hugelton/SumaShield/LICENSES/README.md

# License Notes

This repository contains materials under more than one license:

- Firmware sketches and software documentation are licensed under the MIT License. See `../LICENSE`.
- Hardware design files, manufacturing outputs under `../hardware/`, and hardware-specific documentation are licensed under Creative Commons Attribution-ShareAlike 4.0 International. See `CC-BY-SA-4.0.txt`.
- Third-party Arduino libraries and board support packages are not vendored here. They remain under their upstream licenses.
- Suma Core is referenced as a related project under LGPL-2.1. Its license text is included as `LGPL-2.1.txt` for reference.

Known external build dependencies:

- Raspberry Pi Pico Arduino core / I2S support: upstream Arduino-Pico / bundled dependencies
- U8g2: new BSD / two-clause BSD for U8g2lib code, with separate font license notes upstream
- Adafruit TinyUSB Library: MIT
- MIDI Library by Forty Seven Effects: MIT
