hugelton/SumaShield/hardware/SumaShield.kicad_sch

## KiCad design hardware/SumaShield.kicad_sch (2026-05-06)

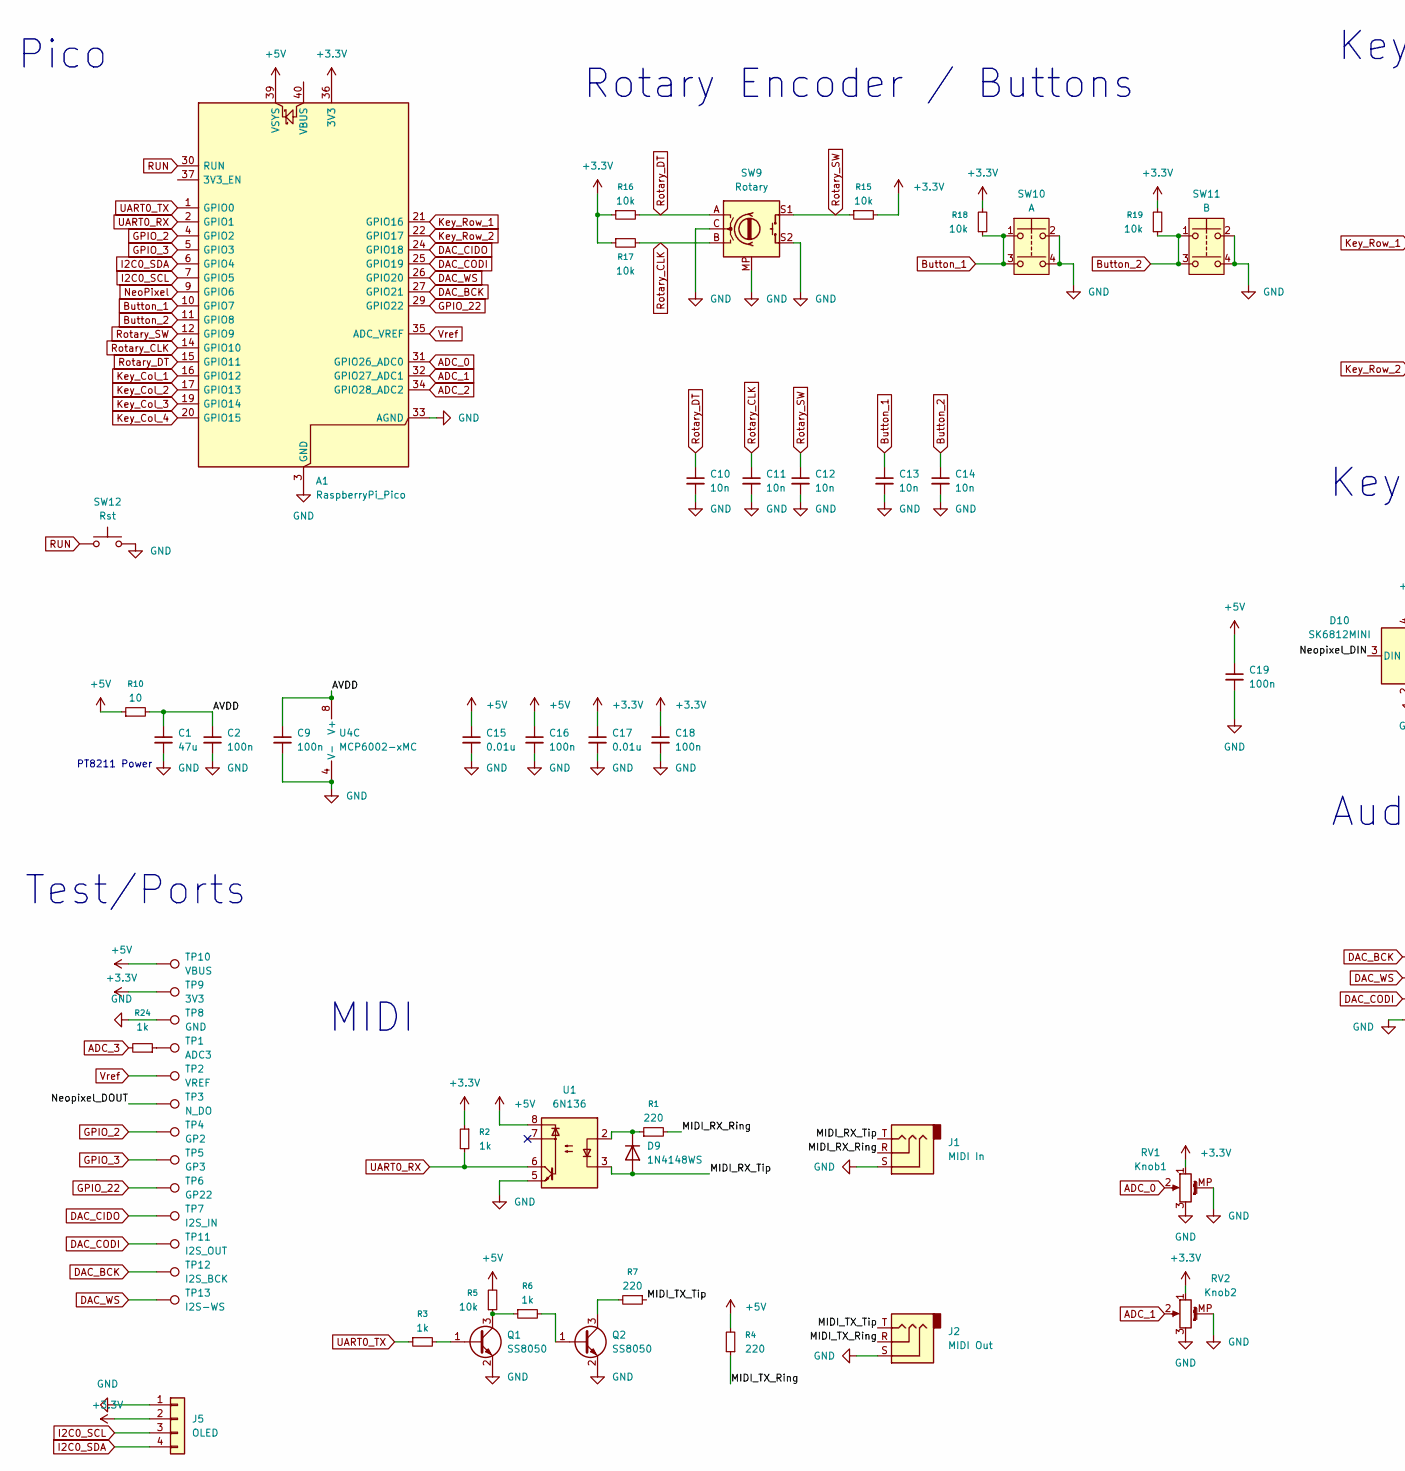
[picture p1: schematic SumaShield.kicad_sch, part in row 1, column 1]

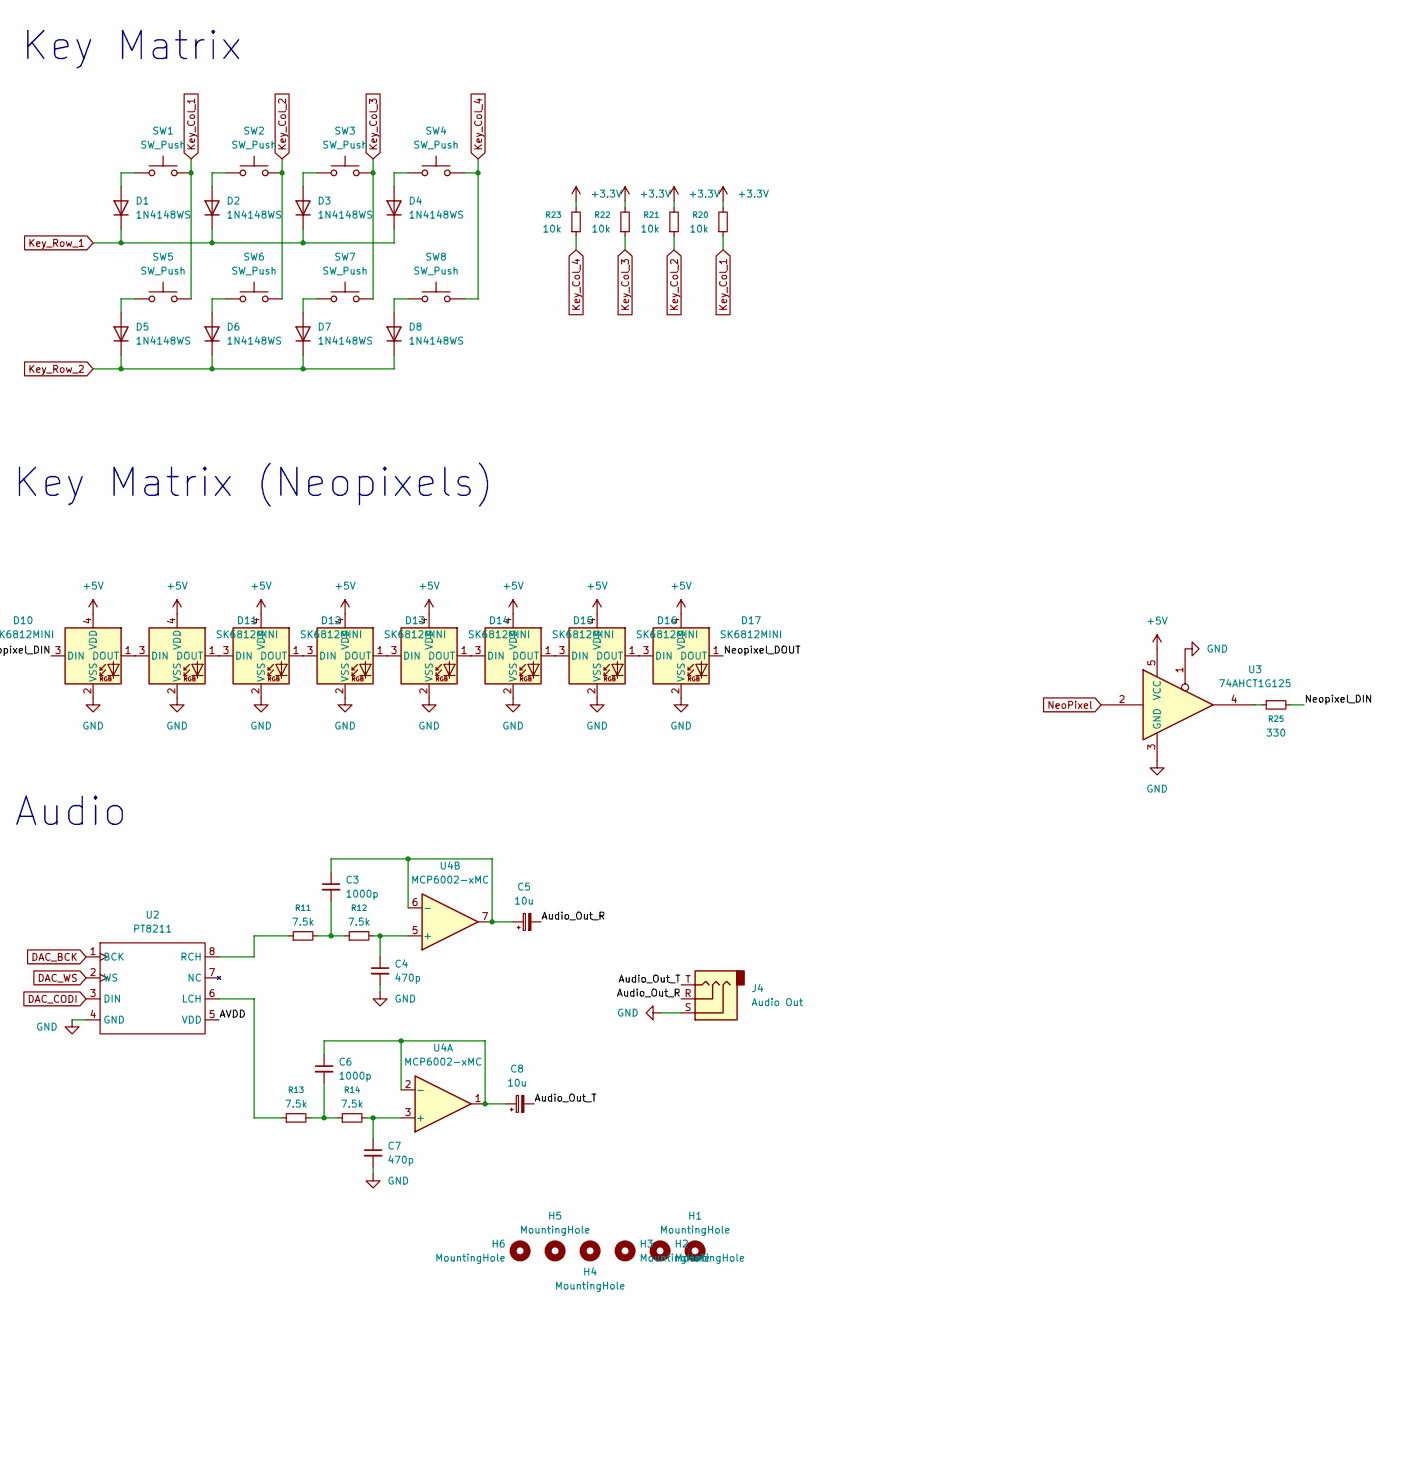
[picture p2: schematic SumaShield.kicad_sch, part in row 1, column 2]

Parts:
A1: RaspberryPi_Pico; RaspberryPi_Pico_Common_THT
C1: 47u; C_0603_1608Metric
C2, C9, C16, C18, C19: 100n; C_0603_1608Metric
C3, C6: 1000p; C_0603_1608Metric
C4, C7: 470p; C_0603_1608Metric
C5, C8: 10u; CP_Elec_6.3x5.4_Nichicon
C10, C11, C12, C13, C14: 10n; C_0603_1608Metric
C15, C17: 0.01u; C_0603_1608Metric
D1, D2, D3, D4, D5, D6, D7, D8, D9: 1N4148WS; D_SOD-323
D10, D11, D12, D13, D14, D15, D16, D17: SK6812MINI; LED_SK6812MINI_Through
H1, H2, H3, H4, H5, H6: MountingHole; MountingHole_3.2mm_M3
J1: MIDI In; Jack_3.5mm_Switronic_ST-005-G_horizontal
J2: MIDI Out; Jack_3.5mm_Switronic_ST-005-G_horizontal
J4: Audio Out; Jack_3.5mm_Switronic_ST-005-G_horizontal
J5: OLED; PinHeader_1x04_P2.54mm_Vertical; Part Number 1-0401FBV0T
Q1, Q2: SS8050; SOT-23
R1, R4, R7: 220; R_0603_1608Metric
R2, R3, R6, R24: 1k; R_0603_1608Metric
R5, R15, R16, R17, R18, R19, R20, R21, R22, R23: 10k; R_0603_1608Metric
R10: 10; R_0603_1608Metric
R11, R12, R13, R14: 7.5k; R_0603_1608Metric
R25: 330; R_0603_1608Metric
RV1: Knob1; ALPS_RK09L_Single_Vertical_15mm
RV2: Knob2; ALPS_RK09L_Single_Vertical_15mm
SW1, SW2, SW3, SW4, SW5, SW6, SW7, SW8: SW_Push; SW_Cherry_MX_1.00u_Plate
SW9: Rotary; RotaryEncoder_Alps_EC11E_Vertical_H20mm_CircularMountingHol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
SW10: A; SW_PUSH_6mm
SW11: B; SW_PUSH_6mm
SW12: Rst; SW_PUSH_1P1T_6x3.5mm_H5.0_APEM_MJTP1250
TP1: ADC3; TestPoint_Pad_D1.5mm
TP2: VREF; TestPoint_Pad_D1.5mm
TP3: N_DO; TestPoint_Pad_D1.5mm
TP4: GP2; TestPoint_Pad_D1.5mm
TP5: GP3; TestPoint_Pad_D1.5mm
TP6: GP22; TestPoint_Pad_D1.5mm
TP7: I2S_IN; TestPoint_Pad_D1.5mm
TP8: GND; TestPoint_Pad_D1.5mm
TP9: 3V3; TestPoint_Pad_D1.5mm
TP10: VBUS; TestPoint_Pad_D1.5mm
TP11: I2S_OUT; TestPoint_Pad_D1.5mm
TP12: I2S_BCK; TestPoint_Pad_D1.5mm
TP13: I2S-WS; TestPoint_Pad_D1.5mm
U1: 6N136; DIP-8_W7.62mm
U2: PT8211; SOP-8_3.76x4.96mm_P1.27mm
U3: 74AHCT1G125; SOT-23-5
U4: MCP6002-xMC; SOIC-8_3.9x4.9mm_P1.27mm

Connections:
+3.3V: A1.36 (3V3), C17.1, C18.1, J5.2, R2.1, R15.2, R16.1, R17.1, R18.2, R19.2, R20.2, R21.2, R22.2, R23.2, RV1.1, RV2.1, TP9.1
+5V: A1.39 (VSYS), C15.1, C16.1, C19.1, D10.4 (VDD), D11.4 (VDD), D12.4 (VDD), D13.4 (VDD), D14.4 (VDD), D15.4 (VDD), D16.4 (VDD), D17.4 (VDD), R4.2, R5.2, R10.1, TP10.1, U1.8, U3.5 (VCC)
ADC_0: A1.31 (GPIO26_ADC0), RV1.2
ADC_1: A1.32 (GPIO27_ADC1), RV2.2
ADC_2: A1.34 (GPIO28_ADC2)
ADC_3: R24.2
AVDD: C1.1, C2.1, C9.1, R10.2, U2.5 (VDD), U4.8 (V+)
Audio_Out_R: C5.2, J4.R
Audio_Out_T: C8.2, J4.T
Button_1: A1.10 (GPIO7), C13.1, R18.1, SW10.1, SW10.3
Button_2: A1.11 (GPIO8), C14.1, R19.1, SW11.1, SW11.3
DAC_BCK: A1.27 (GPIO21), TP12.1, U2.1 (BCK)
DAC_CIDO: A1.24 (GPIO18), TP7.1
DAC_CODI: A1.25 (GPIO19), TP11.1, U2.3 (DIN)
DAC_WS: A1.26 (GPIO20), TP13.1, U2.2 (WS)
GND: A1.3 (GND), A1.8 (GND), A1.13 (GND), A1.18 (GND), A1.23 (GND), A1.28 (GND), A1.33 (AGND), A1.38 (GND), C1.2, C2.2, C4.2, C7.2, C9.2, C10.2, C11.2, C12.2, C13.2, C14.2, C15.2, C16.2, C17.2, C18.2, C19.2, D10.2 (VSS), D11.2 (VSS), D12.2 (VSS), D13.2 (VSS), D14.2 (VSS), D15.2 (VSS), D16.2 (VSS), D17.2 (VSS), J1.S, J2.S, J4.S, J5.1, Q1.2 (E), Q2.2 (E), RV1.3, RV1.MP (MountPin), RV2.3, RV2.MP (MountPin), SW9.C, SW9.MP, SW9.S2, SW10.2, SW10.4, SW11.2, SW11.4, SW12.2, TP8.1, U1.5, U2.4 (GND), U3.1, U3.3 (GND), U4.4 (V-), U4.9 (V-)
GPIO_2: A1.4 (GPIO2), TP4.1
GPIO_3: A1.5 (GPIO3), TP5.1
GPIO_22: A1.29 (GPIO22), TP6.1
I2C0_SCL: A1.7 (GPIO5), J5.3
I2C0_SDA: A1.6 (GPIO4), J5.4
Key_Col_1: A1.16 (GPIO12), R20.1, SW1.2, SW5.2
Key_Col_2: A1.17 (GPIO13), R21.1, SW2.2, SW6.2
Key_Col_3: A1.19 (GPIO14), R22.1, SW3.2, SW7.2
Key_Col_4: A1.20 (GPIO15), R23.1, SW4.2, SW8.2
Key_Row_1: A1.21 (GPIO16), D1.1 (K), D2.1 (K), D3.1 (K), D4.1 (K)
Key_Row_2: A1.22 (GPIO17), D5.1 (K), D6.1 (K), D7.1 (K), D8.1 (K)
MIDI_RX_Ring: J1.R, R1.2
MIDI_RX_Tip: D9.2 (A), J1.T, U1.3
MIDI_TX_Ring: J2.R, R4.1
MIDI_TX_Tip: J2.T, R7.1
NeoPixel: A1.9 (GPIO6), U3.2
Neopixel_DIN: D10.3 (DIN), R25.2
Neopixel_DOUT: D17.1 (DOUT), TP3.1
unnamed: C3.1, C5.1, U4.6 (-), U4.7
unnamed: C3.2, R11.2, R12.1
unnamed: C4.1, R12.2, U4.5 (+)
unnamed: C6.1, C8.1, U4.1, U4.2 (-)
unnamed: C6.2, R13.2, R14.1
unnamed: C7.1, R14.2, U4.3 (+)
unnamed: D1.2 (A), SW1.1
unnamed: D2.2 (A), SW2.1
unnamed: D3.2 (A), SW3.1
unnamed: D4.2 (A), SW4.1
unnamed: D5.2 (A), SW5.1
unnamed: D6.2 (A), SW6.1
unnamed: D7.2 (A), SW7.1
unnamed: D8.2 (A), SW8.1
unnamed: D9.1 (K), R1.1, U1.2
unnamed: D10.1 (DOUT), D11.3 (DIN)
unnamed: D11.1 (DOUT), D12.3 (DIN)
unnamed: D12.1 (DOUT), D13.3 (DIN)
unnamed: D13.1 (DOUT), D14.3 (DIN)
unnamed: D14.1 (DOUT), D15.3 (DIN)
unnamed: D15.1 (DOUT), D16.3 (DIN)
unnamed: D16.1 (DOUT), D17.3 (DIN)
unnamed: Q1.1 (B), R3.2
unnamed: Q1.3 (C), R5.1, R6.1
unnamed: Q2.1 (B), R6.2
unnamed: Q2.3 (C), R7.2
unnamed: R11.1, U2.8 (RCH)
unnamed: R13.1, U2.6 (LCH)
unnamed: R24.1, TP1.1
unnamed: R25.1, U3.4
RUN: A1.30 (RUN), SW12.1
Rotary_CLK: A1.14 (GPIO10), C11.1, R17.2, SW9.B
Rotary_DT: A1.15 (GPIO11), C10.1, R16.2, SW9.A
Rotary_SW: A1.12 (GPIO9), C12.1, R15.1, SW9.S1
UART0_RX: A1.2 (GPIO1), R2.2, U1.6
UART0_TX: A1.1 (GPIO0), R3.1
Vref: A1.35 (ADC_VREF), TP2.1

Notes on the sheet:
Pico
Audio
MIDI
Test/Ports
Key Matrix (Neopixels)
Key Matrix
Rotary Encoder / Buttons
PT8211 Power
