hugelton/SumaShield/applications/SumaPiko/doth/filter.h

// Sample rate: 31000 Hz
#define LPF_MAX 45
int32_t x1_f, x2_f, y1_f, y2_f;
uint8_t filter_lpf(int32_t x, int32_t f_, uint8_t q) {
  int32_t y;
uint8_t f = f_;
if (f_<0) {
    f=0;
}

  if (f>LPF_MAX) f=LPF_MAX;
  if (f==0) {
      y = 4504 * x + 9007 * x1_f + 4504 * x2_f - -2002973 * y1_f - 972411 * y2_f; 
    }
  else if (f==1) {
      y = 5044 * x + 10087 * x1_f + 5044 * x2_f - -1996487 * y1_f - 968085 * y2_f; 
    }
  else if (f==2) {
      y = 5647 * x + 11294 * x1_f + 5647 * x2_f - -1989513 * y1_f - 963526 * y2_f; 
    }
  else if (f==3) {
      y = 6322 * x + 12644 * x1_f + 6322 * x2_f - -1982012 * y1_f - 958725 * y2_f; 
    }
  else if (f==4) {
      y = 7077 * x + 14153 * x1_f + 7077 * x2_f - -1973940 * y1_f - 953671 * y2_f; 
    }
  else if (f==5) {
      y = 7920 * x + 15840 * x1_f + 7920 * x2_f - -1965249 * y1_f - 948353 * y2_f; 
    }
  else if (f==6) {
      y = 8862 * x + 17724 * x1_f + 8862 * x2_f - -1955887 * y1_f - 942759 * y2_f; 
    }
  else if (f==7) {
      y = 9914 * x + 19829 * x1_f + 9914 * x2_f - -1945798 * y1_f - 936880 * y2_f; 
    }
  else if (f==8) {
      y = 11089 * x + 22179 * x1_f + 11089 * x2_f - -1934922 * y1_f - 930703 * y2_f; 
    }
  else if (f==9) {
      y = 12401 * x + 24802 * x1_f + 12401 * x2_f - -1923190 * y1_f - 924218 * y2_f; 
    }
  else if (f==10) {
      y = 13864 * x + 27729 * x1_f + 13864 * x2_f - -1910532 * y1_f - 917413 * y2_f; 
    }
  else if (f==11) {
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
    }
  else if (f==46) {
      y = 93228 * x + -186455 * xh1_f + 93228 * xh2_f - 1046160 * yh1_f - 370495 * yh2_f; 
    }
  else if (f==47) {
      y = 65288 * x + -130575 * xh1_f + 65288 * xh2_f - 1238065 * yh1_f - 450639 * yh2_f; 
    }
  else if (f==48) {
      y = 39603 * x + -79207 * xh1_f + 39603 * xh2_f - 1446967 * yh1_f - 556804 * yh2_f; 
    }
  else {
      y = 17960 * x + -35920 * xh1_f + 17960 * xh2_f - 1674703 * yh1_f - 697966 * yh2_f; 
    }
 y=y>>20;

  xh2_f = xh1_f;
  xh1_f = x;
  yh2_f = yh1_f;
  yh1_f = y;
  return (uint8_t)(y);

}
