hugelton/SumaShield/(commit log)

2026-05-06 Initial commit: SumaShield - RP2040 Music Applications
    - SumaDrums: 8-track drum sequencer with USB/DIN MIDI
    - SumaFormants: Monophonic formant vocoder synth
    - MIDITester: MIDI diagnostic tool
    - Dual-core architecture (UI + DSP)
    - OLED auto-sleep, real-time parameter control
    License: MIT (Software), CC BY-SA 4.0 (Hardware), LGPL-2.1 (Suma Core)
    Author: Leo Kuroshita @kurogedelic
    [SumaShield.kicad_sch, bom.csv, positions.csv]
2026-05-06 docs: Clarify multi-license structure and add full license texts
    - Update .gitignore with clearer description
    - Enhance README license section with detailed scope
    - Add full CC BY-SA 4.0 license text
    - Add full LGPL-2.1 license text for Suma Core reference
    - Add LICENSES/README.md explaining license structure
    - Document external dependencies (Arduino Pico, U8g2, TinyUSB, MIDI Library)
    License structure:
    - Firmware: MIT License
    - Hardware: CC BY-SA 4.0
    - Suma Core: LGPL-2.1 (external reference)
2026-05-06 fix: Correct hardware specifications
    - Update I2S DAC to PT8211 (on-board, not PCM5102)
    - Clarify Pico/Pico2/clone compatibility
    - Specify Cherry MX compatible key switches
    - Update pin configuration notes
2026-05-06 Add applications with version numbers and improvements
    - Add version numbers to all applications (1.0.0)
    - Add README.md files for all applications
    - Add NeopixelTest application for testing WS2812 LED
    - Update SumaDrums with trigger debounce (50ms) to prevent double-triggering
    - Update SumaFormants: rotary encoder now controls formant offset (±100Hz) instead of pitch
    - Add SumaPiko: lo-fi music mangler (currently NOT WORKING - I2S conversion in progress)
    - Update main README with hardware version v0.5
    [MIDITester.ino, NeopixelTest.ino, SumaDrums.ino, SumaFormants.ino, SumaPiko.ino, button.h]
2026-05-06 Convert hardware section to table format
    - Add Components table with Required/Notes/Link columns
    - Add Pin Configuration table with GPIO/Description/Notes columns
    - Include datasheet links for major components
    - Improve readability and reference
2026-05-06 Update hardware specs for v0.5
    Major changes:
    - Split Raspberry Pi Pico/Pico 2 as separate options (Pico 2 A4+ recommended)
    - Add OLED options: 72x40 (recommended) or 128x64 (may have noise)
    - Remove MIDI DIN connector (not present on hardware)
    - Add TRS 3.5mm MJ-8435 as required (MIDI TRS IN/OUT + Audio Out)
    - Add optional electret mic module (SparkFun BOB-12758, ADC3 rear pad, requires soldering)
    - Add NeoPixel SK6812MINI-E as not supported in v0.5 (planned for future)
    - Update pin configuration table
    - Update hardware version history
2026-05-06 Restructure README: position SumaShield as open hardware platform
    - Reposition SumaShield as "open-source audio/MIDI shield platform" not "app collection"
    - Add Philosophy section explaining platform-first approach
    - Rename Applications → Example Applications (secondary, not primary)
    - Move detailed hardware specs from README to HARDWARE.md
    - Remove firmware-specific details (22.05kHz, dual-core) from main README
    - Emphasize Pico/Pico2 ecosystem relationship
    - Add platform-oriented Quick Start and Development sections
    - Update HARDWARE.md with comprehensive technical documentation
    - Keep existing license declarations in HARDWARE.md
    Goals:
    - Clarify that SumaShield is a reus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
2026-05-13 Add PixelSynth: 16x16 LED matrix visual synth
    New application demonstrating visual synthesis on SumaShield:
    - 6 procedural animation modes (Noise Mesh, Voronoi, Plasma, Ripples, Matrix Rain, Fire)
    - Key-based mode switching (keys 0-5)
    - Knob 1: Speed/Scale control
    - Knob 2: Color offset control
    - Rotary encoder: Fine parameter adjustment
    - Button A: Flash white VJ effect
    - OLED 72x40: Shows mode name and parameter values
    - FastLED library for WS2812B/SK6812MINI-E
    - 256 LEDs (16x16 matrix) on GPIO 6
    Hardware requirements:
    - SumaShield v0.6+ (NeoPixel GPIO 6 required)
    - Not compatible with v0.5 (GPIO 6 not populated)
    - Firmware ready for future hardware revisions
    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
    [PixelSynth.ino]
2026-05-13 Change PixelSynth FastLED output to GPIO 2
    Update all references from GPIO 6 to GPIO 2:
    - NEOPIXEL_PIN changed from 6 to 2
    - Updated hardware requirements to specify external LED matrix on GPIO 2
    - Removed "not populated in v0.5" warnings
    - Updated technical specs and troubleshooting
    - Clarified that LED matrix is user-provided external hardware
2026-05-13 Add Tetris modes to PixelSynth
    Add two new visual modes (modes 6-7) using keys 6-7:
    - Mode 6 (Tetris X): 2x2 block, Knob 1 controls horizontal position
    - Mode 7 (Tetris Rot): 4x1 vertical block, Button A cycles rotation
    Changes:
    - Increase MAX_MODES from 6 to 8
    - Add tetris_x and tetris_rot state variables
    - Implement drawTetrisX() and drawTetrisRot() functions
    - Add button A state tracking for rotation detection
    - Update knob 1 handling to control tetris X position in mode 6
    - Update button A handling: mode 7 uses rotation, modes 0-6 use flash
    - Add mode names and descriptions to README
2026-05-13 Prepare Tetris and PONG game state variables
    Add comprehensive state for Tetris (mode 6) and PONG (mode 7):
    - Tetromino shape definitions for all 7 types with rotations
    - Game board array (16x16)
    - Score tracking, game over state
    - PONG ball physics and paddle state
    This is preparation for full game implementation.
2026-05-13 Implement Tetris game logic and controls
    Implement playable Tetris game for mode 6:
    Game logic:
    - Tetromino shape definitions for all 7 types (I,O,T,S,Z,J,L)
    - Game board array (16x16) with collision detection
    - Piece validation, locking, line clearing with score tracking
    - Game over detection and initialization
    Controls (mode 6 only):
    - Rotary encoder: horizontal movement (left/right)
    - Rotary button click: hard drop (instant fall)
    - Auto-drop every 10 frames
    - Different colors per tetromino type
    Visuals:
    - Draw board with locked pieces
    - Draw current falling piece
    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
    [PixelSynth.ino]
